AbdouNaili/Embedded-Road-Safety-System-Infrastructure-Driver-Vehicle-Monitoring/enclosure/enclosure_box.stl

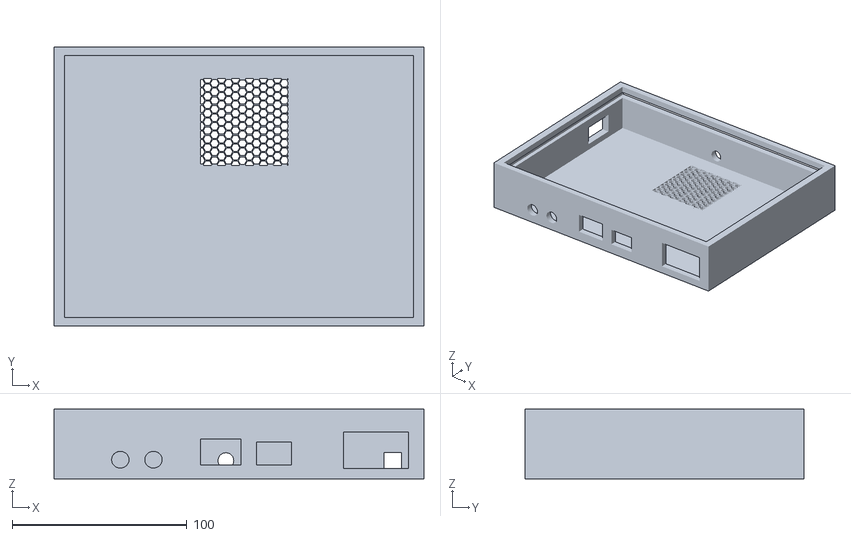
[picture p7: CAD file, 2026-10-26]
enclosure/enclosure_box.stl
212.0 x 160.0 x 40.0
