AbdouNaili/Embedded-Road-Safety-System-Infrastructure-Driver-Vehicle-Monitoring/enclosure/enclosure_lid.stl

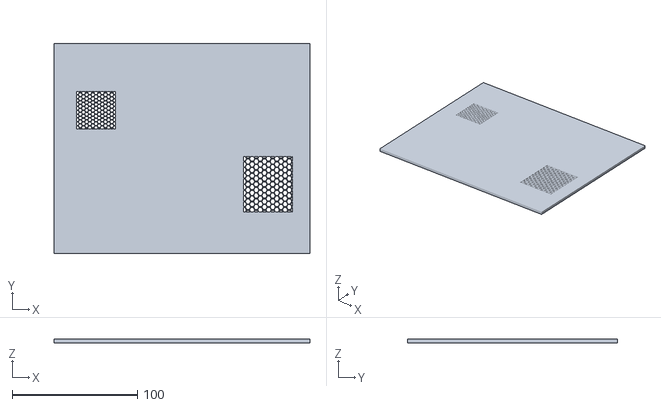
[picture p8: CAD file, 2026-10-26]
enclosure/enclosure_lid.stl
204.0 x 167.0 x 3.00
